soenkef/arduino_focusser/img/Attachment-1-2.png

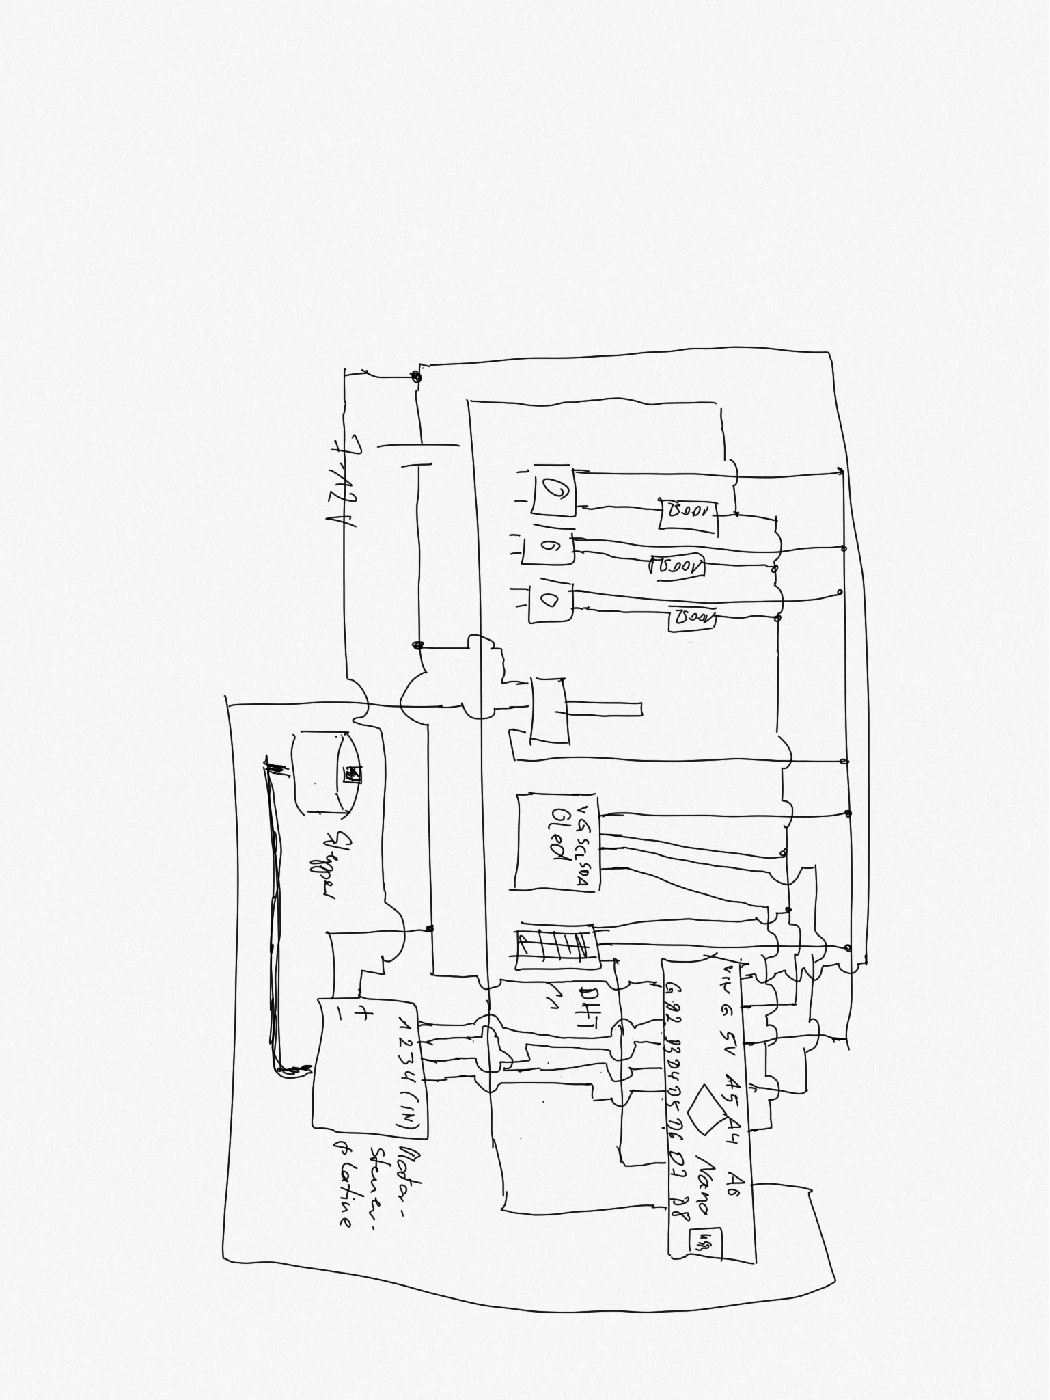
img/Attachment-1-2.png
