soenkef/arduino_focusser/img/Sketches 1.png

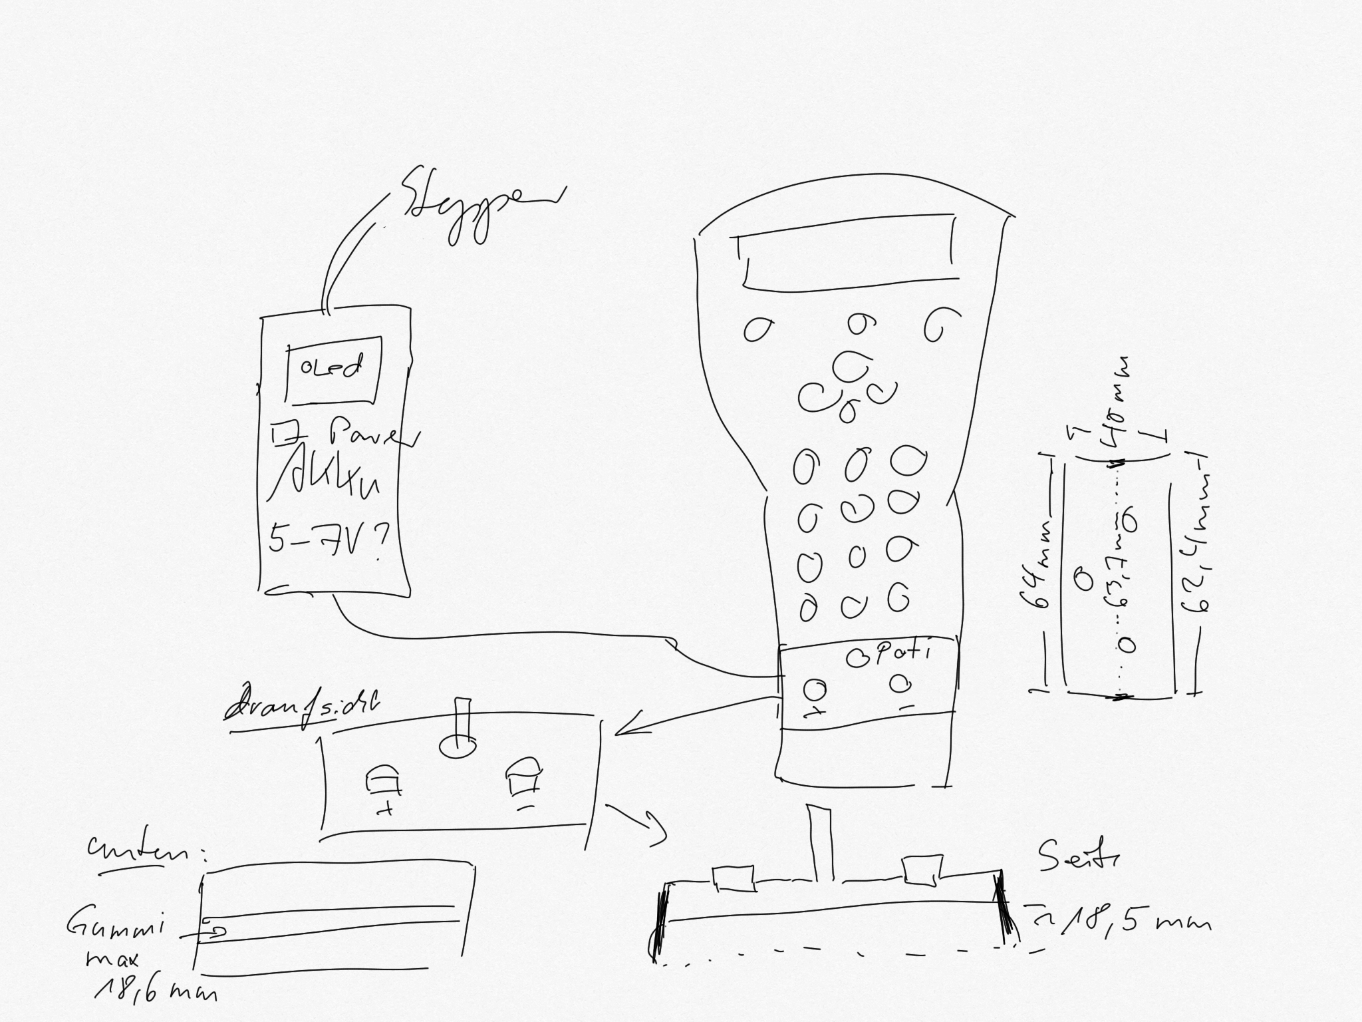
img/Sketches 1.png
