soenkef/arduino_focusser/img/Sketches 2.png

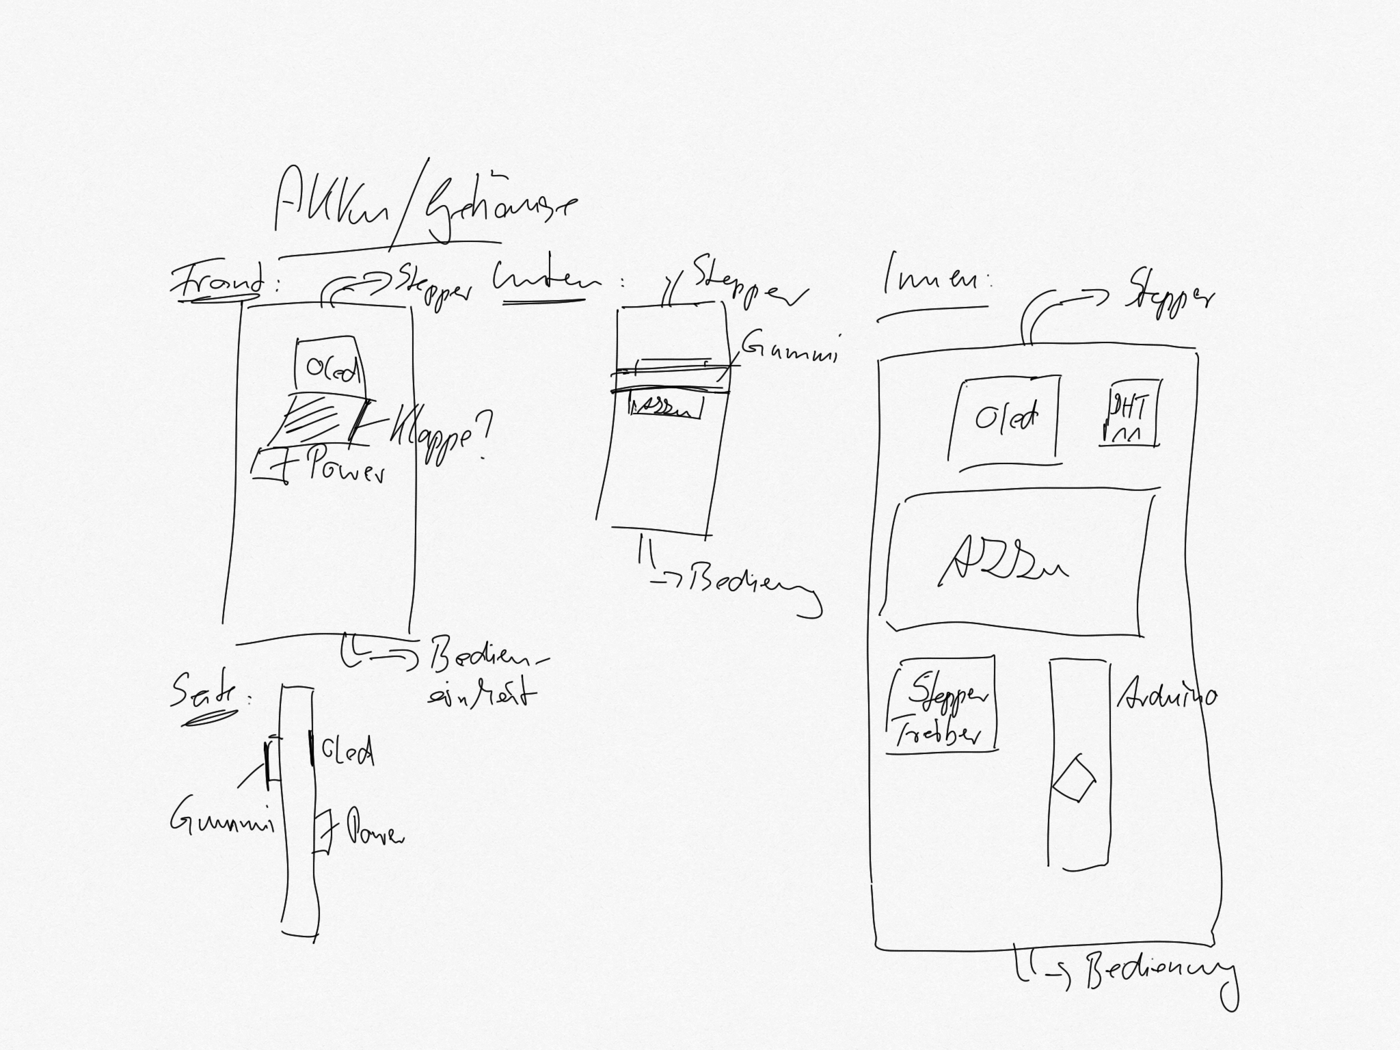
img/Sketches 2.png
