soenkef/arduino_focusser/img/Sketches 3.png

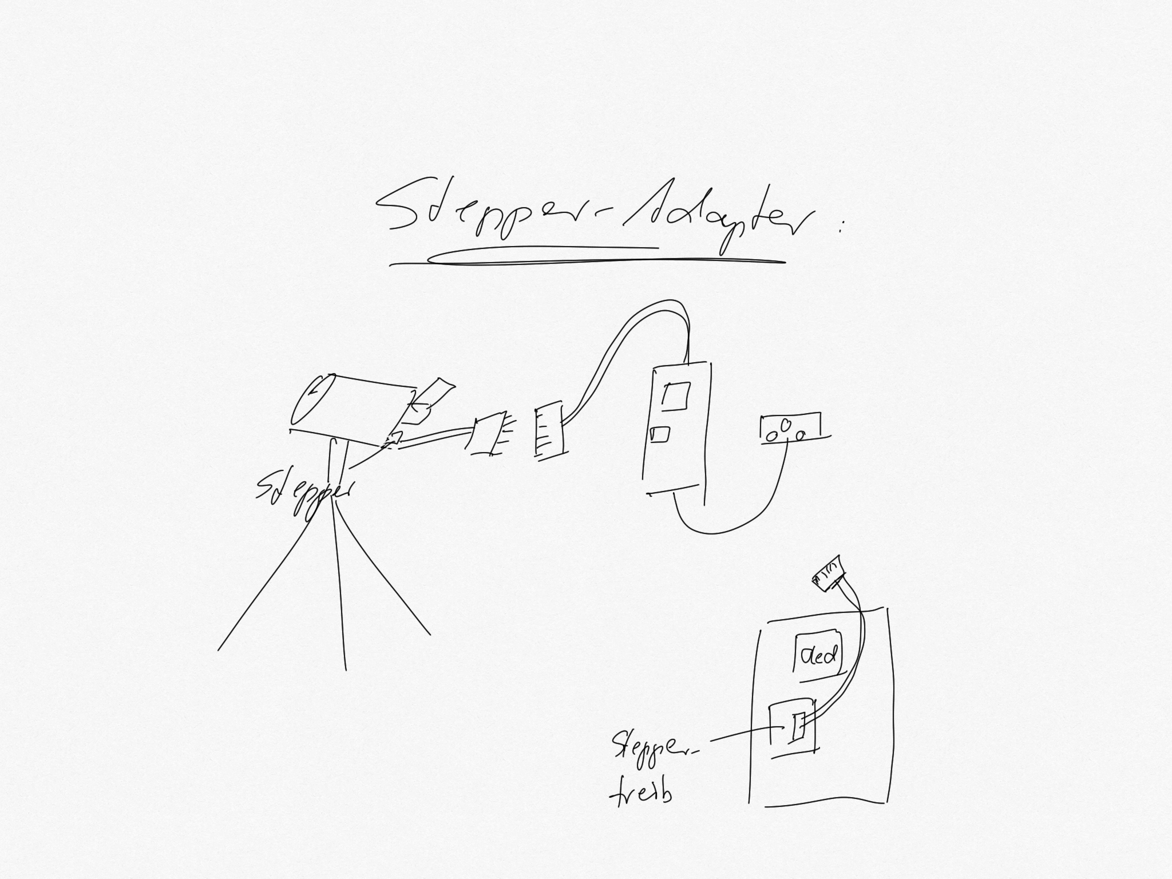
img/Sketches 3.png
