soenkef/arduino_focusser/img/Sketches 4.png

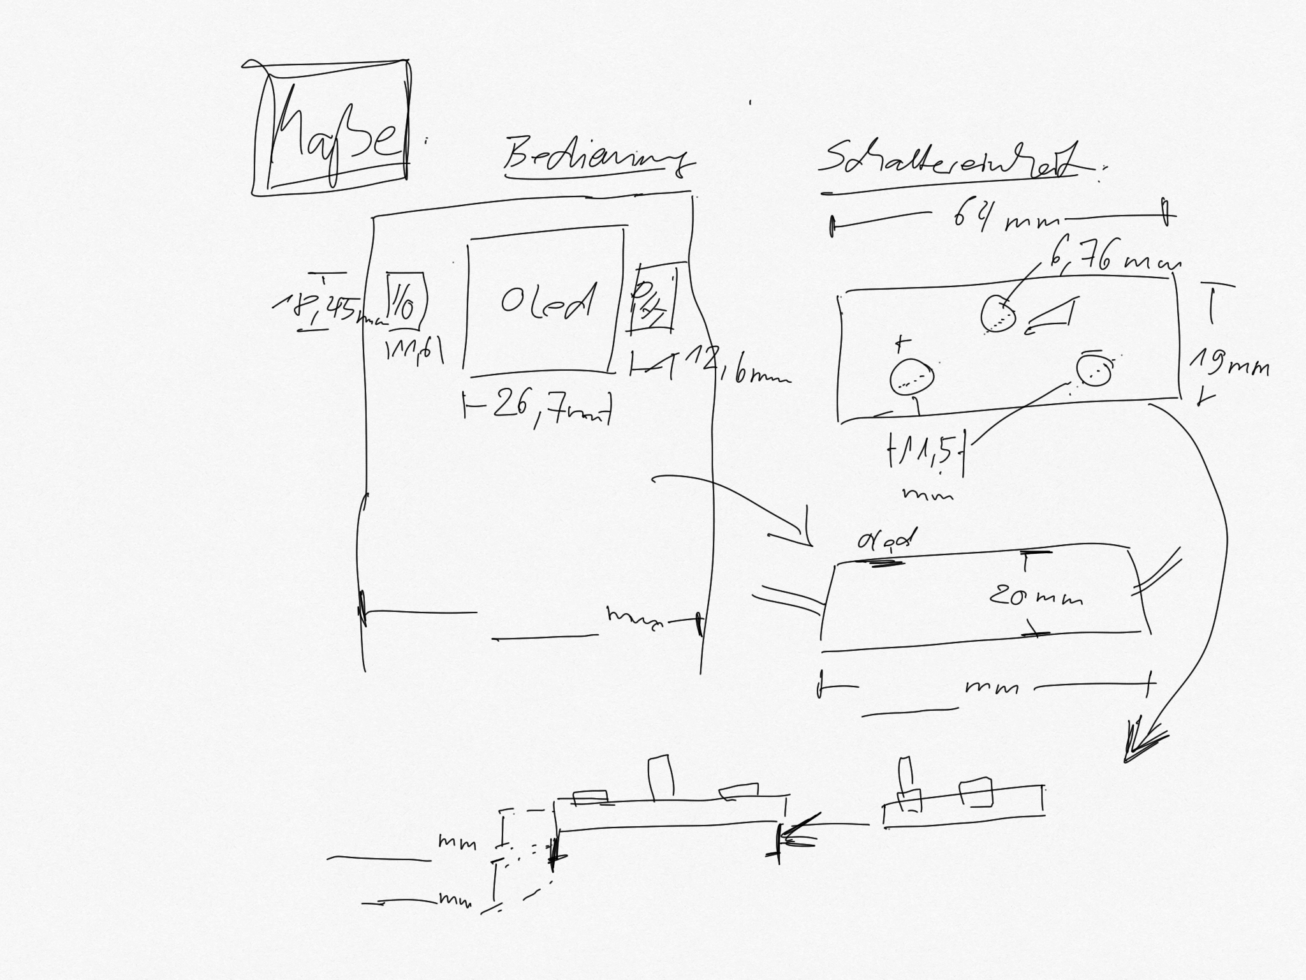
img/Sketches 4.png
