soenkef/arduino_focusser/stl/Bedienpanel.stl

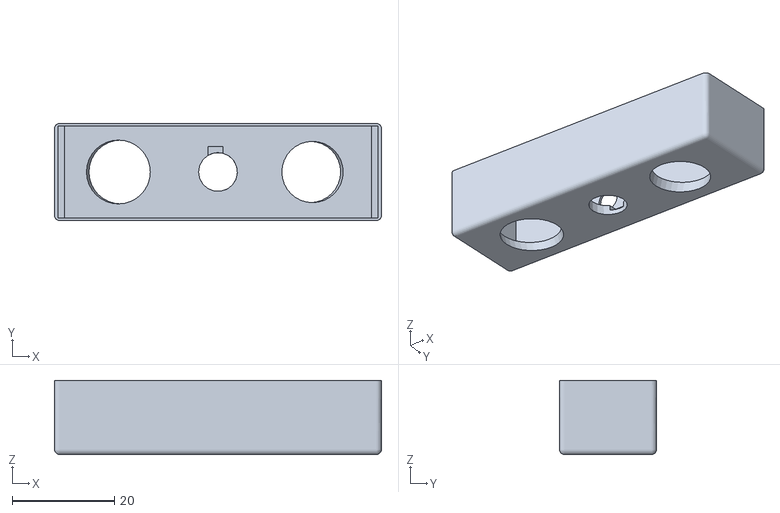
[picture p35: CAD file, 2021-05-08]
stl/Bedienpanel.stl
64.0 x 19.0 x 14.5
