soenkef/arduino_focusser/stl/Stepper-Gehaeuse_Box_Decken_hinten.stl

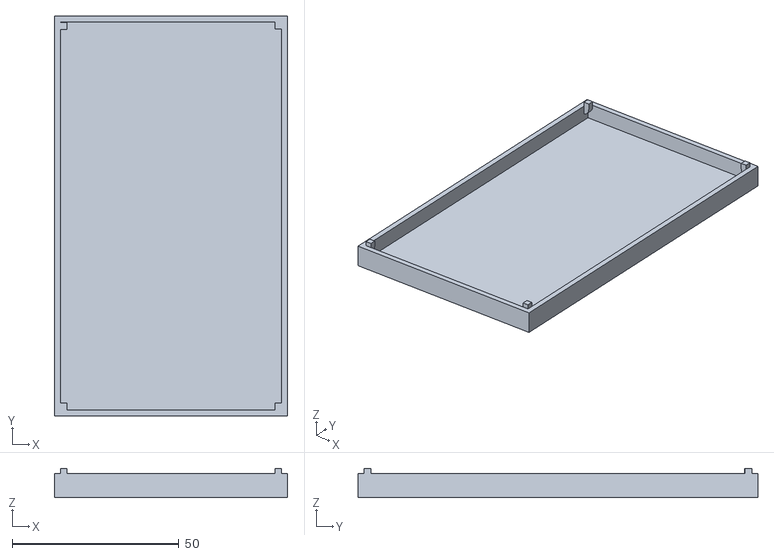
[picture p36: CAD file, 2021-05-08]
stl/Stepper-Gehaeuse_Box_Decken_hinten.stl
70.0 x 120.0 x 8.77
