soenkef/arduino_focusser/stl/Stepper-Gehaeuse_Box_Front.stl

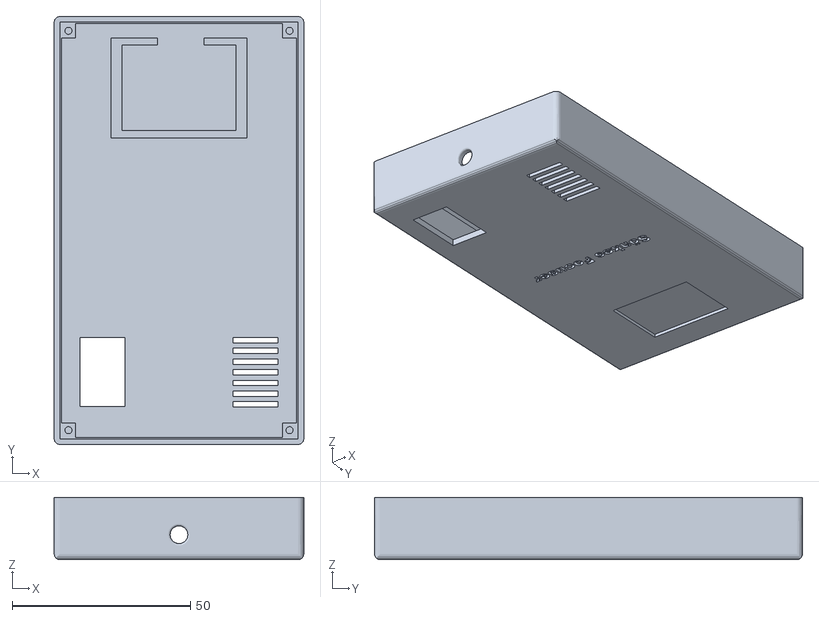
[picture p37: CAD file, 2021-05-08]
stl/Stepper-Gehaeuse_Box_Front.stl
70.0 x 120.0 x 17.5
