soenkef/arduino_focusser/stl/Bedienpanel_Deckel.stl

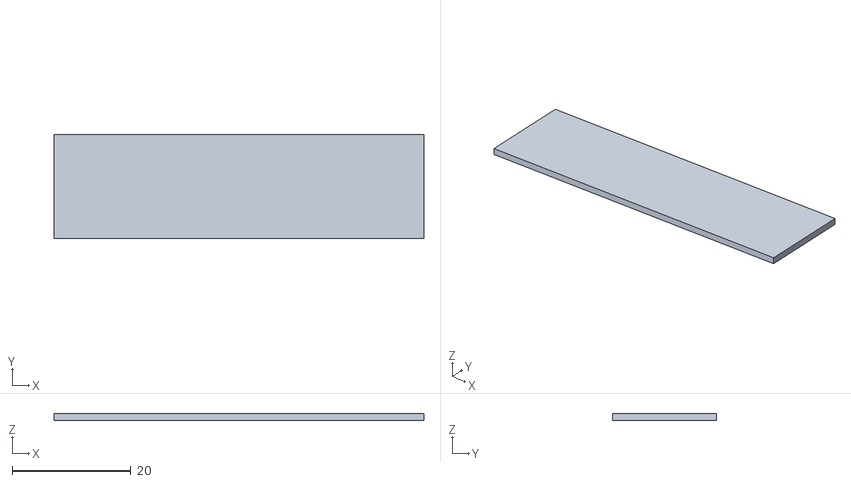
[picture p38: CAD file, 2021-04-28]
stl/Bedienpanel_Deckel.stl
62.3 x 17.5 x 1.20
