soenkef/arduino_focusser/(commit log)

2021-04-23 add dht for temp and humedity, prepare poti for stepper speed
2021-04-24 add button up function
2021-04-25 motor uses both directions now
2021-04-25 set values for stepper steps
2021-04-28 constructed case and some paintings of project
2021-04-28 create printable stl files for cases
    [Bedienpanel.stl, Bedienpanel_Deckel.stl, Stepper-Gehaeuse_Box_Decken_hinten.stl, Stepper-Gehaeuse_Box_Front.stl]
2021-04-28 add printable gcode files
2021-04-29 modified case for DHT11
    [Stepper-Gehaeuse_Box_Front.stl]
2021-04-30 modify cases - make bigger and make place for OLED and poti, refactor code - comment buttonExtra
    [Bedienpanel.stl, Bedienpanel_Deckel.stl, Stepper-Gehaeuse_Box_Decken_hinten.stl, Stepper-Gehaeuse_Box_Front.stl]
2021-05-08 new case - modified for better fit of oled, move button and sensor to the rim
    [Bedienpanel.stl, Stepper-Gehaeuse_Box_Decken_hinten.stl, Stepper-Gehaeuse_Box_Front.stl]
